iwasz/uniwersal/README.md

# uniwersal
Universal board and shields for it. Below is a photo of version 1.0
