iwasz/uniwersal/3battery/ref-1.png

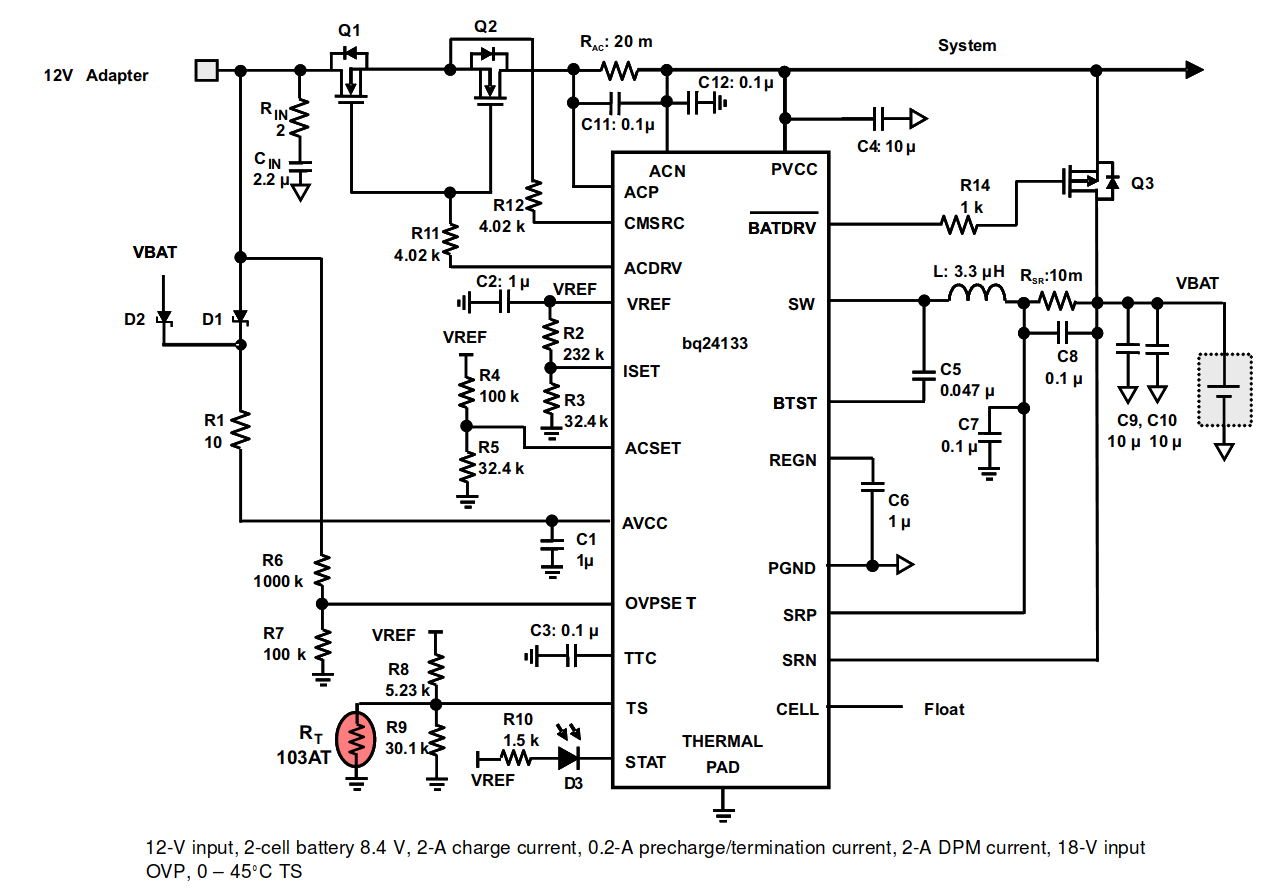
3battery/ref-1.png
