iwasz/uniwersal/3battery/ref-2.png

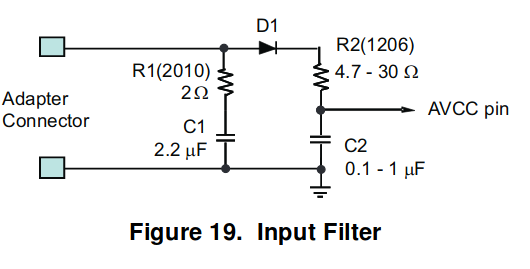
3battery/ref-2.png
