iwasz/uniwersal/3battery/ref-3.png

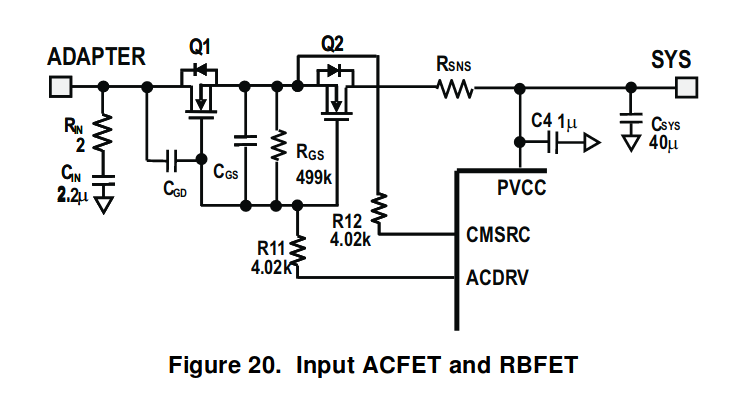
3battery/ref-3.png
