iwasz/uniwersal/3battery/3battery-Edge.Cuts.dxf

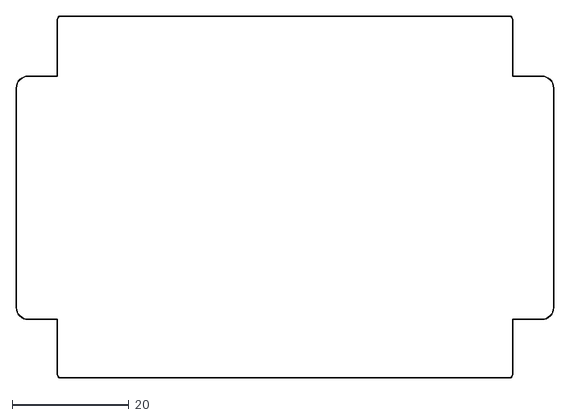
[picture p4: CAD file, 2018-02-04]
3battery/3battery-Edge.Cuts.dxf
92.0 x 61.9
