iwasz/uniwersal/3battery/3battery.kicad_pcb

## KiCad design 3battery/3battery.kicad_pcb (2018-04-09)

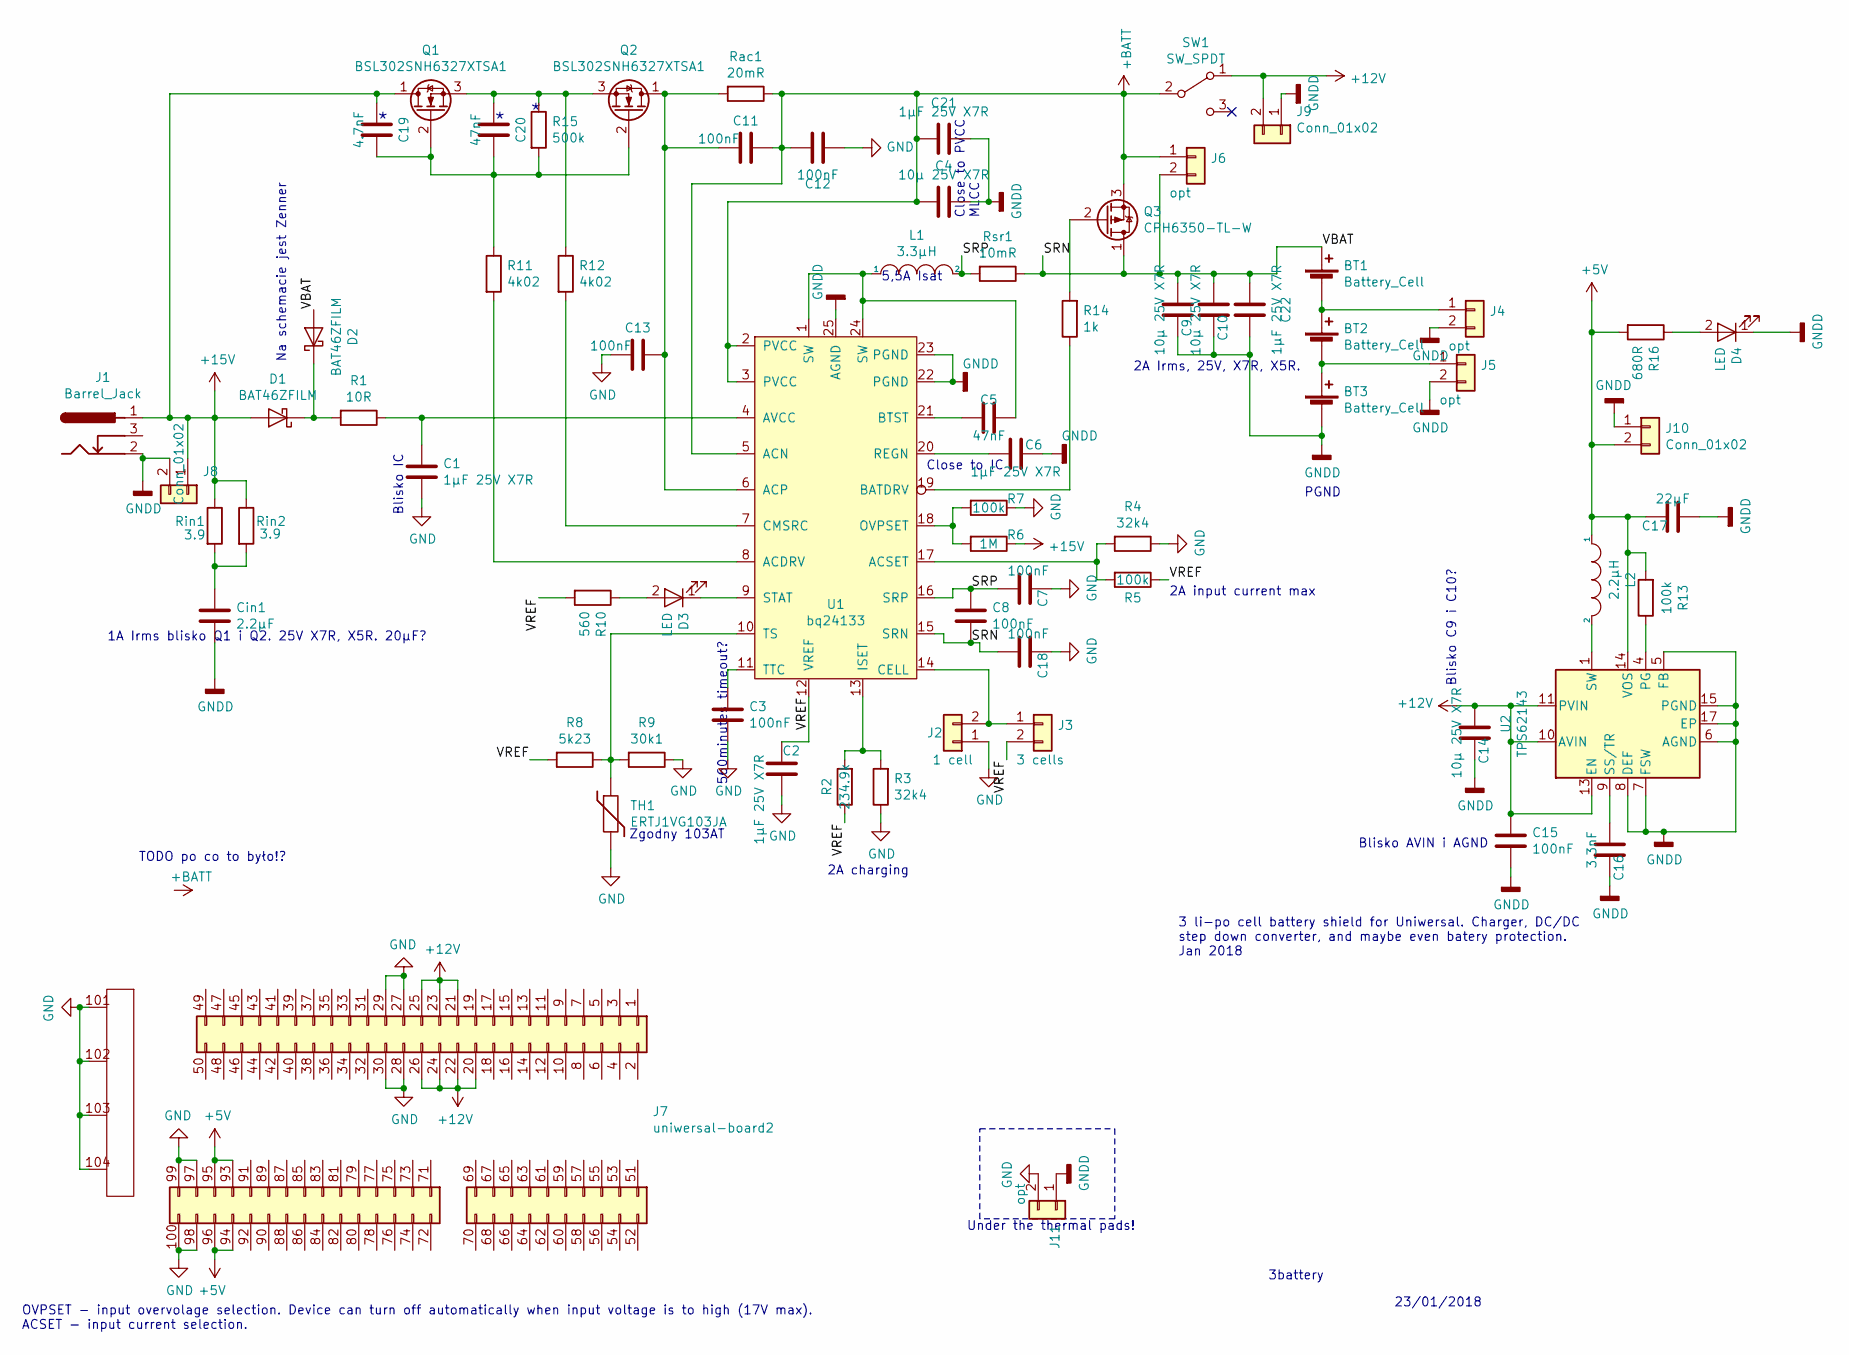
[picture p5: schematic 3battery.sch]

Parts:
BT1, BT2, BT3: Battery_Cell; BLM-BH18650-PC2
C1, C2, C6, C21, C22: 1µF 25V X7R; C_0805_2012Metric
C3, C7, C8, C11, C12, C13, C15, C18: 100nF; C_0603_1608Metric
C4, C9, C10, C14: 10µ 25V X7R; C_1206_3216Metric
C5, C20: 47nF; C_0603_1608Metric
C16: 3.3nF; C_0603_1608Metric
C17: 22µF; C_1206_3216Metric
C19: 4.7nF; C_0603_1608Metric
Cin1: 2.2µF; C_0805_2012Metric
D1, D2: BAT46ZFILM; D_SOD-123
D3, D4: LED; D_0805_2012Metric
J1: Barrel_Jack; BarrelJack_Horizontal
J2: 1 cell; SolderJumper-2_P1.3mm_Open_RoundedPad1.0x1.5mm
J3: 3 cells; SolderJumper-2_P1.3mm_Bridged_RoundedPad1.0x1.5mm
J4, J5, J6: opt; SolderJumper-2_P1.3mm_Open_RoundedPad1.0x1.5mm
J7: uniwersal-board2; uniwersal-board
J8, J9, J10: Conn_01x02; PinHeader_1x02_P2.54mm_Vertical
J11: opt; R_0402_1005Metric
L1: 3.3µH; L_7.3x7.3_H3.5
L2: 2.2µH; L_6.3x6.3_H3
Q1, Q2: BSL302SNH6327XTSA1; TSOP-6_1.65x3.05mm_P0.95mm-BSLMOSFET
Q3: CPH6350-TL-W; TSOT-23-6-POWER_MOSFET
R1: 10R; R_1206_3216Metric
R2: 234.9k; R_0603_1608Metric
R3, R4: 32k4; R_0603_1608Metric
R5, R7, R13: 100k; R_0603_1608Metric
R6: 1M; R_0603_1608Metric
R8: 5k23; R_0603_1608Metric
R9: 30k1; R_0603_1608Metric
R10: 560; R_0603_1608Metric
R11, R12: 4k02; R_0603_1608Metric
R14: 1k; R_0603_1608Metric
R15: 500k; R_0603_1608Metric
R16: 680R; R_0603_1608Metric
Rac1: 20mR; R_1206_3216Metric
Rin1, Rin2: 3.9; R_2010_5025Metric
Rsr1: 10mR; R_1206_3216Metric
SW1: SW_SPDT; SW_CuK_OS102011MA1QN1_SPDT_Angled
TH1: ERTJ1VG103JA; R_0603_1608Metric
U1: bq24133; R-PVQFN-N24
U2: TPS62143; QFN-16-1EP_3x3mm_P0.5mm_EP2.7x2.7mm_ThermalVias

Connections:
+5V: C17.1, J7.93 (Pin_23), J7.94 (Pin_24), J7.95 (Pin_25), J7.96 (Pin_26), J10.2, L2.1, R13.2, R16.2, U2.14 (VOS)
+12V: C14.2, C15.1, J7.20, J7.21, J7.22, J7.23, J7.24, J7.25, J7.26, J9.2, SW1.1 (A), U2.10 (AVIN), U2.11 (PVIN), U2.12 (PVIN), U2.13 (EN)
+15V: C19.1, D1.2 (A), J1.1, J8.1, Q1.1 (D), R6.1, Rin1.1, Rin2.1
+BATT: C4.2, C11.2, C12.1, C21.2, J6.1, Q3.3 (S), Rac1.1, SW1.2 (B), U1.2 (PVCC), U1.3 (PVCC), U1.5 (ACN)
/SRN: BT1.1 (+), C8.2, C9.2, C10.2, C18.2, C22.2, D2.2 (A), J6.2, Q3.1 (D), Rsr1.1, U1.15 (SRN)
/SRP: C7.2, C8.1, L1.2, Rsr1.2, U1.16 (SRP)
/VREF: C2.1, J3.2, R2.1, R5.1, R8.2, R10.2, U1.12 (VREF)
GND: C1.2, C2.2, C3.2, C7.1, C12.2, C13.1, C18.1, J2.1, J7.27, J7.28, J7.29, J7.30, J7.97 (Pin_27), J7.98 (Pin_28), J7.99 (Pin_29), J7.100 (Pin_30), J7.101, J7.102, J7.103, J7.104, J11.2, R3.1, R4.1, R7.1, R9.1, TH1.2
GNDD: BT3.2 (-), C4.1, C6.1, C9.1, C10.1, C14.1, C15.2, C16.1, C17.2, C21.1, C22.1, Cin1.2, D4.1 (K), J1.2, J4.2, J5.2, J8.2, J9.1, J10.1, J11.1, U1.22 (PGND), U1.23 (PGND), U1.25 (AGND), U2.5 (FB), U2.6 (AGND), U2.7 (FSW), U2.8 (DEF), U2.15 (PGND), U2.16 (PGND), U2.17 (EP)
unnamed: BT1.2 (-), BT2.1 (+), J4.1
unnamed: BT2.2 (-), BT3.1 (+), J5.1
unnamed: C1.1, R1.1, U1.4 (AVCC)
unnamed: C3.1, U1.11 (TTC)
unnamed: C5.1, L1.1, U1.1 (SW), U1.24 (SW)
unnamed: C5.2, U1.21 (BTST)
unnamed: C6.2, U1.20 (REGN)
unnamed: C11.1, C13.2, Q2.1 (D), Rac1.2, U1.6 (ACP)
unnamed: C16.2, U2.9 (SS/TR)
unnamed: C19.2, C20.2, Q1.2 (G), Q2.2 (G), R11.1, R15.2
unnamed: C20.1, Q1.3 (S), Q2.3 (S), R12.1, R15.1
unnamed: Cin1.1, Rin1.2, Rin2.2
unnamed: D1.1 (K), D2.1 (K), R1.2
unnamed: D3.1 (K), U1.9 (STAT)
unnamed: D3.2 (A), R10.1
unnamed: D4.2 (A), R16.1
unnamed: J2.2, J3.1, U1.14 (CELL)
unnamed: L2.2, U2.1 (SW), U2.2 (SW), U2.3 (SW)
unnamed: Q3.2 (G), R14.2
unnamed: R2.2, R3.2, U1.13 (ISET)
unnamed: R4.2, R5.2, U1.17 (ACSET)
unnamed: R6.2, R7.2, U1.18 (OVPSET)
unnamed: R8.1, R9.2, TH1.1, U1.10 (TS)
unnamed: R11.2, U1.8 (ACDRV)
unnamed: R12.2, U1.7 (CMSRC)
unnamed: R13.1, U2.4 (PG)
unnamed: R14.1, U1.19 (BATDRV)

Notes on the sheet:
Na schemacie jest Zenner
Blisko IC
3battery
23/01/2018
3 li-po cell battery shield for Uniwersal. Charger, DC/DC step down converter, and maybe even batery protection. Jan 2018
Blisko C9 i C10?
Blisko AVIN i AGND
OVPSET - input overvolage selection. Device can turn off automatically when input voltage is to high (17V max). ACSET - input current selection.
PGND
Close to PVCC MLCC
Close to IC
2A charging
2A input current max
560minutes timeout?
Zgodny 103AT
5,5A Isat
1A Irms blisko Q1 i Q2. 25V X7R, X5R. 20µF?
2A Irms, 25V, X7R, X5R.
Under the thermal pads!
TODO po co to było!?

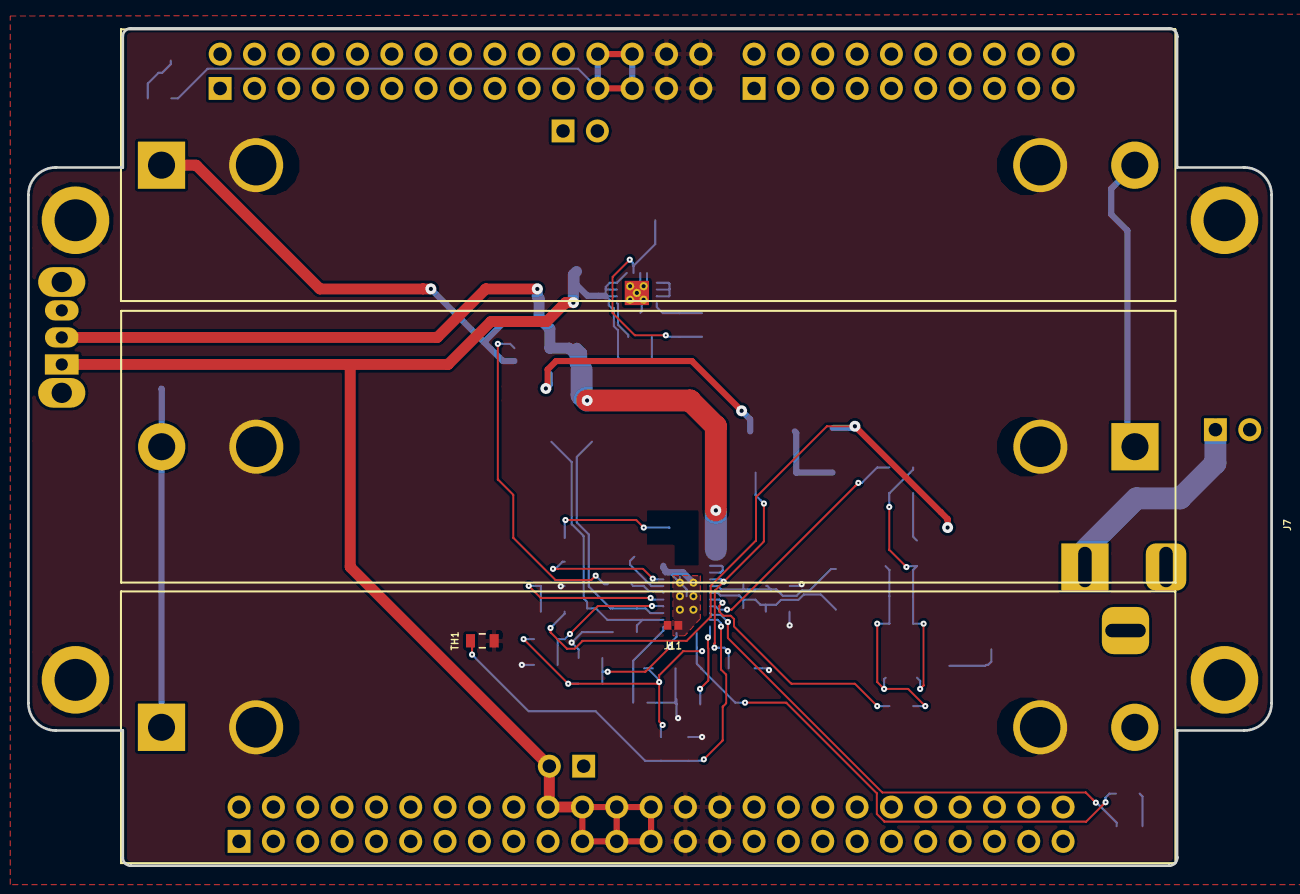
[picture p6: board 3battery.kicad_pcb from above]

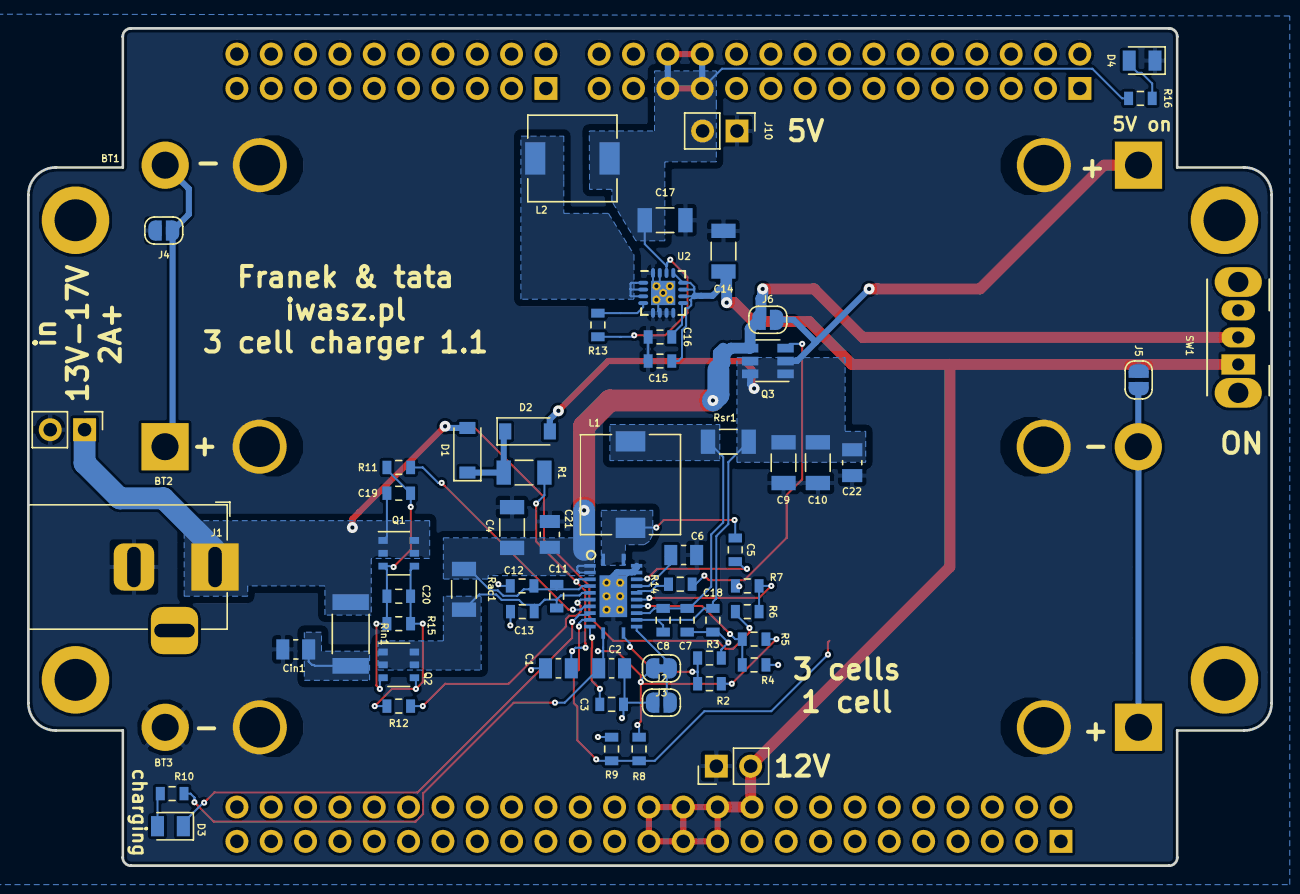
[picture p7: board 3battery.kicad_pcb from below]

Board: 2 copper layers, 92.0 x 61.9 mm, 69 parts (63 on the bottom side), 36 nets.
