iwasz/uniwersal/mainBoard/mainBoard.kicad_pcb

## KiCad design mainBoard/mainBoard.kicad_pcb (2018-04-09)

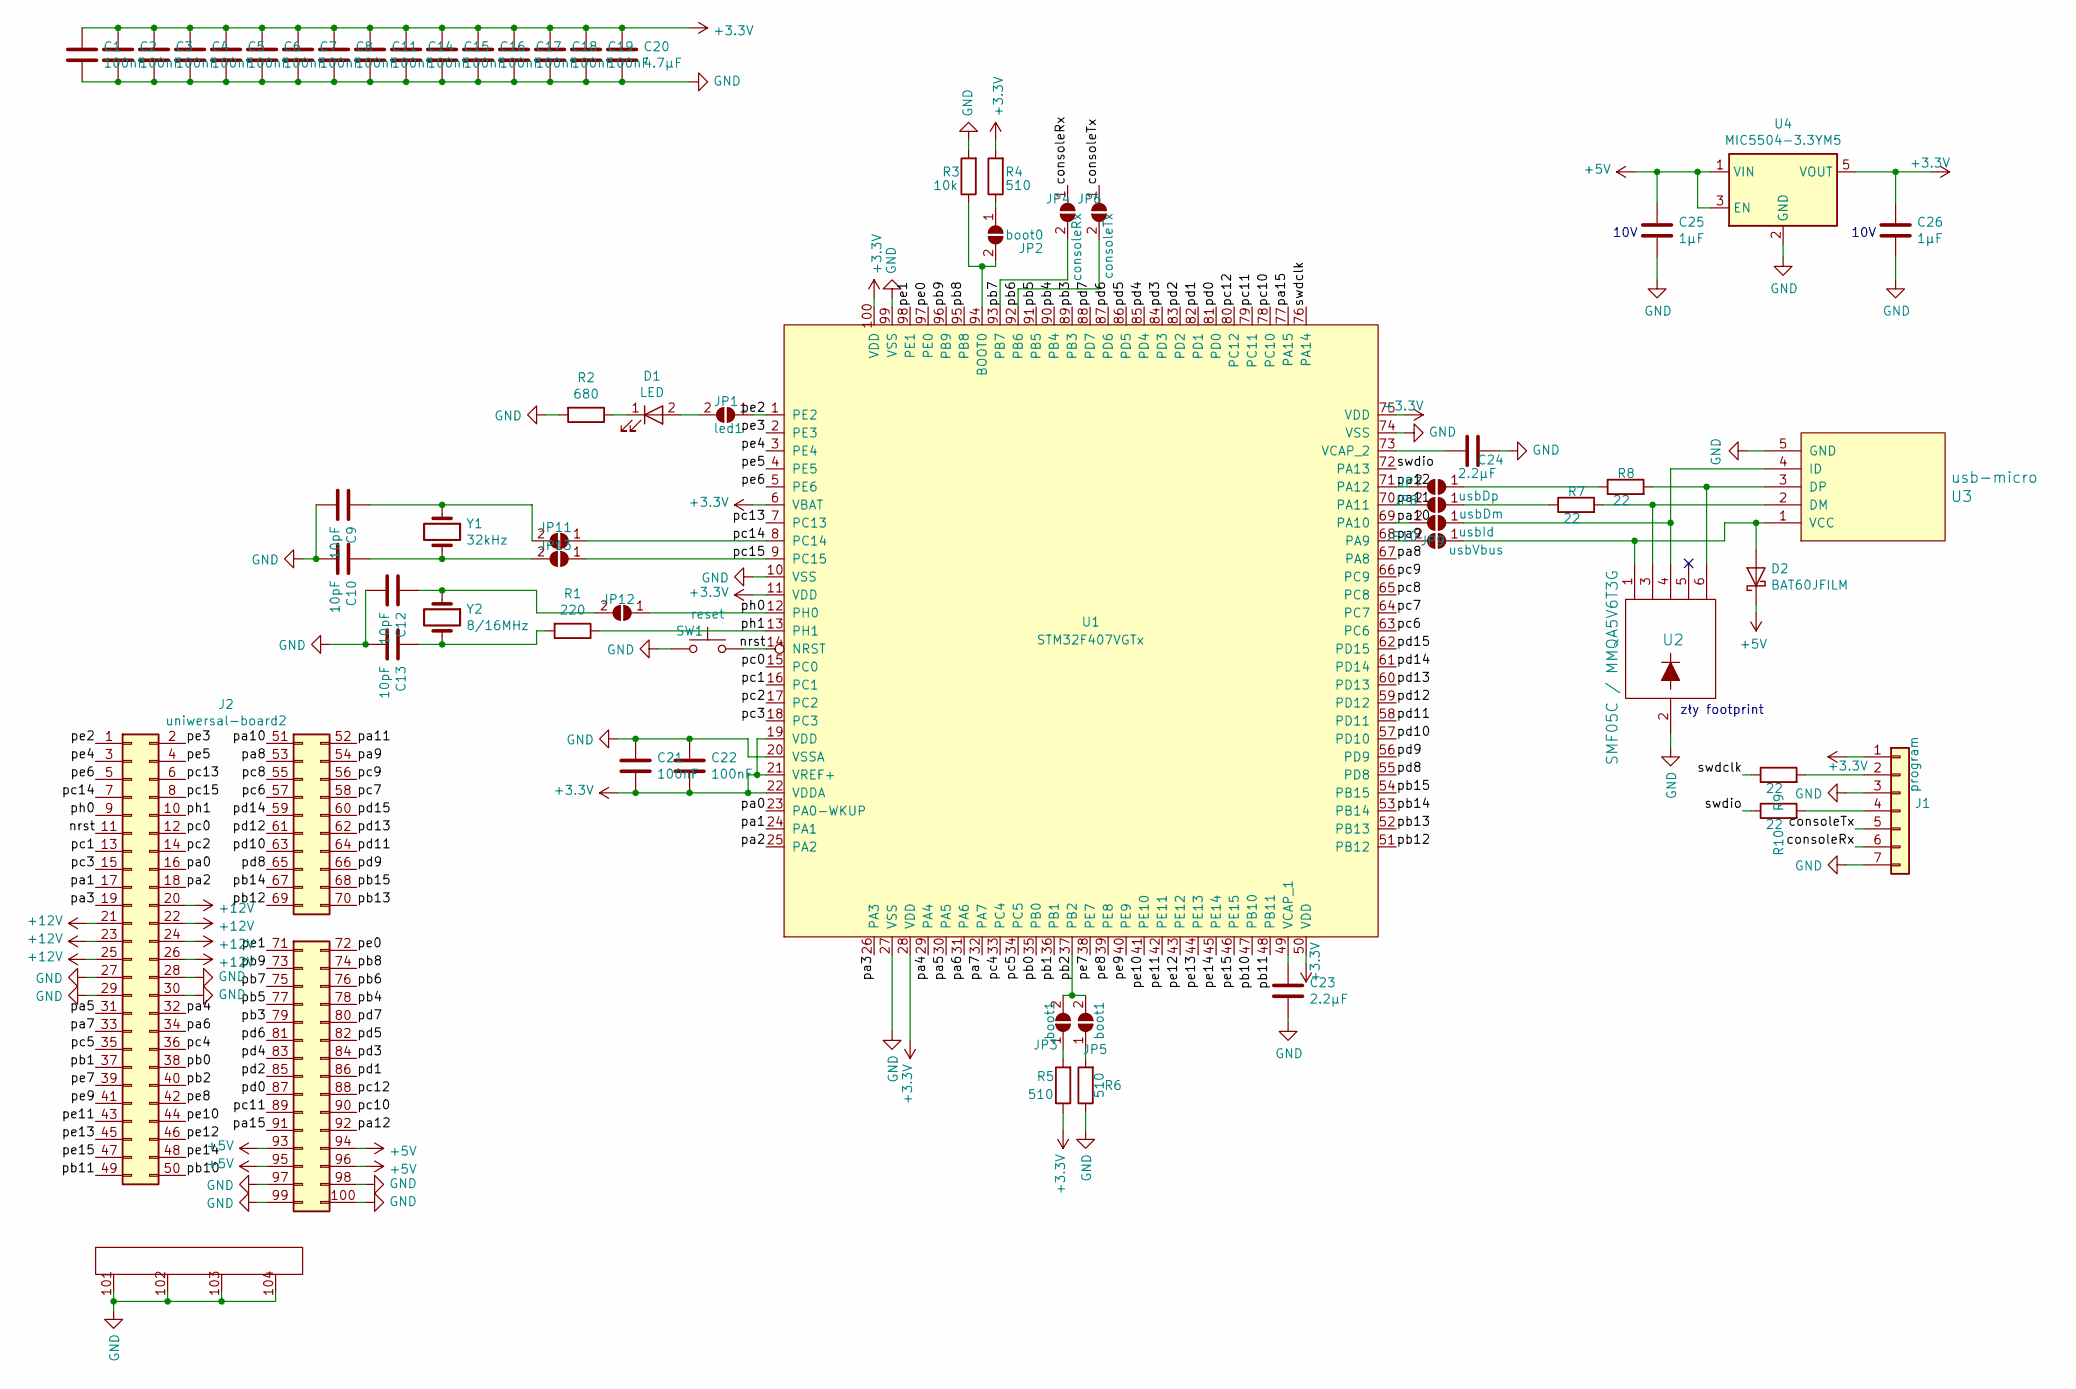
[picture p8: schematic mainBoard.sch]

Parts:
C1, C2, C3, C4, C5, C6, C7, C8, C11, C14, C15, C16, C17, C18, C19, C21, C22: 100nF; C_0603_1608Metric
C9, C10, C12, C13: 10pF; C_0603_1608Metric
C20: 4.7µF; C_1206_3216Metric
C23, C24: 2.2µF; C_1206_3216Metric
C25, C26: 1µF; C_0805_2012Metric
D1: LED; LED_0805_2012Metric
D2: BAT60JFILM; D_SOD-323
J1: program; PinHeader_1x07_P2.00mm_Vertical
J2: uniwersal-board2; uniwersal-board
JP1: led1; SolderJumper-2_P1.3mm_Open_RoundedPad1.0x1.5mm
JP2: boot0; SolderJumper-2_P1.3mm_Open_RoundedPad1.0x1.5mm
JP3, JP5: boot1; SolderJumper-2_P1.3mm_Open_RoundedPad1.0x1.5mm
JP4: consoleRx; SolderJumper-2_P1.3mm_Bridged_RoundedPad1.0x1.5mm
JP6: consoleTx; SolderJumper-2_P1.3mm_Bridged_RoundedPad1.0x1.5mm
JP7: usbDp; SolderJumper-2_P1.3mm_Bridged_RoundedPad1.0x1.5mm
JP8: usbDm; SolderJumper-2_P1.3mm_Bridged_RoundedPad1.0x1.5mm
JP9: usbId; SolderJumper-2_P1.3mm_Open_RoundedPad1.0x1.5mm
JP10: usbVbus; SolderJumper-2_P1.3mm_Open_RoundedPad1.0x1.5mm
JP11, JP13: x; SolderJumper-2_P1.3mm_Open_RoundedPad1.0x1.5mm
JP12: x32; SolderJumper-2_P1.3mm_Bridged_RoundedPad1.0x1.5mm
R1: 220; R_0603_1608Metric
R2: 680; R_0603_1608Metric
R3: 10k; R_0603_1608Metric
R4, R5, R6: 510; R_0603_1608Metric
R7, R8, R9, R10: 22; R_0603_1608Metric
SW1: reset; SW_Tactile_SPST_Angled_PTS645Vx83-2LFS
U1: STM32F407VGTx; LQFP-100_14x14mm_P0.5mm
U2: SMF05C / MMQA5V6T3G; SOT-363_SC-70-6
U3: usb-micro; conn_usb_B_micro_smd-2-nohole
U4: MIC5504-3.3YM5; SOT-23-5
Y1: 32kHz; Crystal_C38-LF_D3.0mm_L8.0mm_Horizontal
Y2: 8/16MHz; Crystal_HC49-4H_Vertical

Connections:
+3V3: C1.1, C2.1, C3.1, C4.1, C5.1, C6.1, C7.1, C8.1, C11.1, C14.1, C15.1, C16.1, C17.1, C18.1, C19.1, C20.1, C21.1, C22.2, C26.1, J1.1, R4.2, R5.1, U1.6 (VBAT), U1.11 (VDD), U1.19 (VDD), U1.21 (VREF+), U1.22 (VDDA), U1.28 (VDD), U1.50 (VDD), U1.75 (VDD), U1.100 (VDD), U4.5 (VOUT)
+5V: C25.1, D2.1 (K), J2.93 (Pin_23), J2.94 (Pin_24), J2.95 (Pin_25), J2.96 (Pin_26), U4.1 (VIN), U4.3 (EN)
+12V: J2.20, J2.21, J2.22, J2.23, J2.24, J2.25, J2.26
/consoleRx: J1.6, JP4.1 (A)
/consoleTx: J1.5, JP6.1 (A)
/nrst: J2.11, SW1.2, U1.14 (NRST)
/pa0: J2.16, U1.23 (PA0-WKUP)
/pa1: J2.17, U1.24 (PA1)
/pa2: J2.18, U1.25 (PA2)
/pa3: J2.19, U1.26 (PA3)
/pa4: J2.32, U1.29 (PA4)
/pa5: J2.31, U1.30 (PA5)
/pa6: J2.34, U1.31 (PA6)
/pa7: J2.33, U1.32 (PA7)
/pa8: J2.53 (Pin_3), U1.67 (PA8)
/pa9: J2.54, JP10.2 (B), U1.68 (PA9)
/pa10: J2.51 (Pin_1), JP9.2 (B), U1.69 (PA10)
/pa11: J2.52 (Pin_2), JP8.2 (B), U1.70 (PA11)
/pa12: J2.92 (Pin_22), JP7.2 (B), U1.71 (PA12)
/pa15: J2.91 (Pin_21), U1.77 (PA15)
/pb0: J2.38, U1.35 (PB0)
/pb1: J2.37, U1.36 (PB1)
/pb2: J2.40, JP3.2 (B), JP5.2 (B), U1.37 (PB2)
/pb3: J2.79 (Pin_9), U1.89 (PB3)
/pb4: J2.78 (Pin_8), U1.90 (PB4)
/pb5: J2.77 (Pin_7), U1.91 (PB5)
/pb6: J2.76 (Pin_6), JP6.2 (B), U1.92 (PB6)
/pb7: J2.75 (Pin_5), JP4.2 (B), U1.93 (PB7)
/pb8: J2.74 (Pin_4), U1.95 (PB8)
/pb9: J2.73 (Pin_3), U1.96 (PB9)
/pb10: J2.50, U1.47 (PB10)
/pb11: J2.49, U1.48 (PB11)
/pb12: J2.69, U1.51 (PB12)
/pb13: J2.70 (Pin_20), U1.52 (PB13)
/pb14: J2.67 (Pin_17), U1.53 (PB14)
/pb15: J2.68 (Pin_18), U1.54 (PB15)
/pc0: J2.12, U1.15 (PC0)
/pc1: J2.13, U1.16 (PC1)
/pc2: J2.14, U1.17 (PC2)
/pc3: J2.15, U1.18 (PC3)
/pc4: J2.36, U1.33 (PC4)
/pc5: J2.35, U1.34 (PC5)
/pc6: J2.57 (Pin_7), U1.63 (PC6)
/pc7: J2.58 (Pin_8), U1.64 (PC7)
/pc8: J2.55 (Pin_5), U1.65 (PC8)
/pc9: J2.56 (Pin_6), U1.66 (PC9)
/pc10: J2.90 (Pin_20), U1.78 (PC10)
/pc11: J2.89 (Pin_19), U1.79 (PC11)
/pc12: J2.88 (Pin_18), U1.80 (PC12)
/pc13: J2.6, U1.7 (PC13)
/pc14: J2.7, JP11.1 (A), U1.8 (PC14)
/pc15: J2.8, JP13.1 (A), U1.9 (PC15)
/pd0: J2.87 (Pin_17), U1.81 (PD0)
/pd1: J2.86 (Pin_16), U1.82 (PD1)
/pd2: J2.85 (Pin_15), U1.83 (PD2)
/pd3: J2.84 (Pin_14), U1.84 (PD3)
/pd4: J2.83 (Pin_13), U1.85 (PD4)
/pd5: J2.82 (Pin_12), U1.86 (PD5)
/pd6: J2.81, U1.87 (PD6)
/pd7: J2.80 (Pin_10), U1.88 (PD7)
/pd8: J2.65 (Pin_15), U1.55 (PD8)
/pd9: J2.66 (Pin_16), U1.56 (PD9)
/pd10: J2.63 (Pin_13), U1.57 (PD10)
/pd11: J2.64 (Pin_14), U1.58 (PD11)
/pd12: J2.61 (Pin_11), U1.59 (PD12)
/pd13: J2.62, U1.60 (PD13)
/pd14: J2.59 (Pin_9), U1.61 (PD14)
/pd15: J2.60 (Pin_10), U1.62 (PD15)
/pe0: J2.72 (Pin_2), U1.97 (PE0)
/pe1: J2.71 (Pin_1), U1.98 (PE1)
/pe2: J2.1, JP1.1 (A), U1.1 (PE2)
/pe3: J2.2, U1.2 (PE3)
/pe4: J2.3, U1.3 (PE4)
/pe5: J2.4, U1.4 (PE5)
/pe6: J2.5, U1.5 (PE6)
/pe7: J2.39, U1.38 (PE7)
/pe8: J2.42, U1.39 (PE8)
/pe9: J2.41, U1.40 (PE9)
/pe10: J2.44, U1.41 (PE10)
/pe11: J2.43, U1.42 (PE11)
/pe12: J2.46, U1.43 (PE12)
/pe13: J2.45, U1.44 (PE13)
/pe14: J2.48, U1.45 (PE14)
/pe15: J2.47, U1.46 (PE15)
/ph0: J2.9, JP12.1 (A), U1.12 (PH0)
/ph1: J2.10, R1.1, U1.13 (PH1)
/swdclk: R9.1, U1.76 (PA14)
/swdio: R10.1, U1.72 (PA13)
GND: C1.2, C2.2, C3.2, C4.2, C5.2, C6.2, C7.2, C8.2, C9.1, C10.1, C11.2, C12.1, C13.1, C14.2, C15.2, C16.2, C17.2, C18.2, C19.2, C20.2, C21.2, C22.1, C23.2, C24.1, C25.2, C26.2, J1.3, J1.7, J2.27, J2.28, J2.29, J2.30, J2.97 (Pin_27), J2.98 (Pin_28), J2.99 (Pin_29), J2.100 (Pin_30), J2.101, J2.102, J2.103, J2.104, R2.2, R3.2, R6.1, SW1.1, U1.10 (VSS), U1.20 (VSSA), U1.27 (VSS), U1.74 (VSS), U1.99 (VSS), U2.2, U3.5 (GND), U4.2 (GND)
unnamed: C9.2, JP11.2 (B), Y1.1
unnamed: C10.2, JP13.2 (B), Y1.2
unnamed: C12.2, JP12.2 (B), Y2.1
unnamed: C13.2, R1.2, Y2.2
unnamed: C23.1, U1.49 (VCAP_1)
unnamed: C24.2, U1.73 (VCAP_2)
unnamed: D1.1 (K), R2.1
unnamed: D1.2 (A), JP1.2 (B)
unnamed: D2.2 (A), JP10.1 (A), U2.1, U3.1 (VCC)
unnamed: J1.2, R9.2
unnamed: J1.4, R10.2
unnamed: JP2.1 (A), R4.1
unnamed: JP2.2 (B), R3.1, U1.94 (BOOT0)
unnamed: JP3.1 (A), R5.2
unnamed: JP5.1 (A), R6.2
unnamed: JP7.1 (A), R8.1
unnamed: JP8.1 (A), R7.1
unnamed: JP9.1 (A), U2.4, U3.4 (ID)
unnamed: R7.2, U2.3, U3.2 (DM)
unnamed: R8.2, U2.6, U3.3 (DP)

Notes on the sheet:
10V
zły footprint

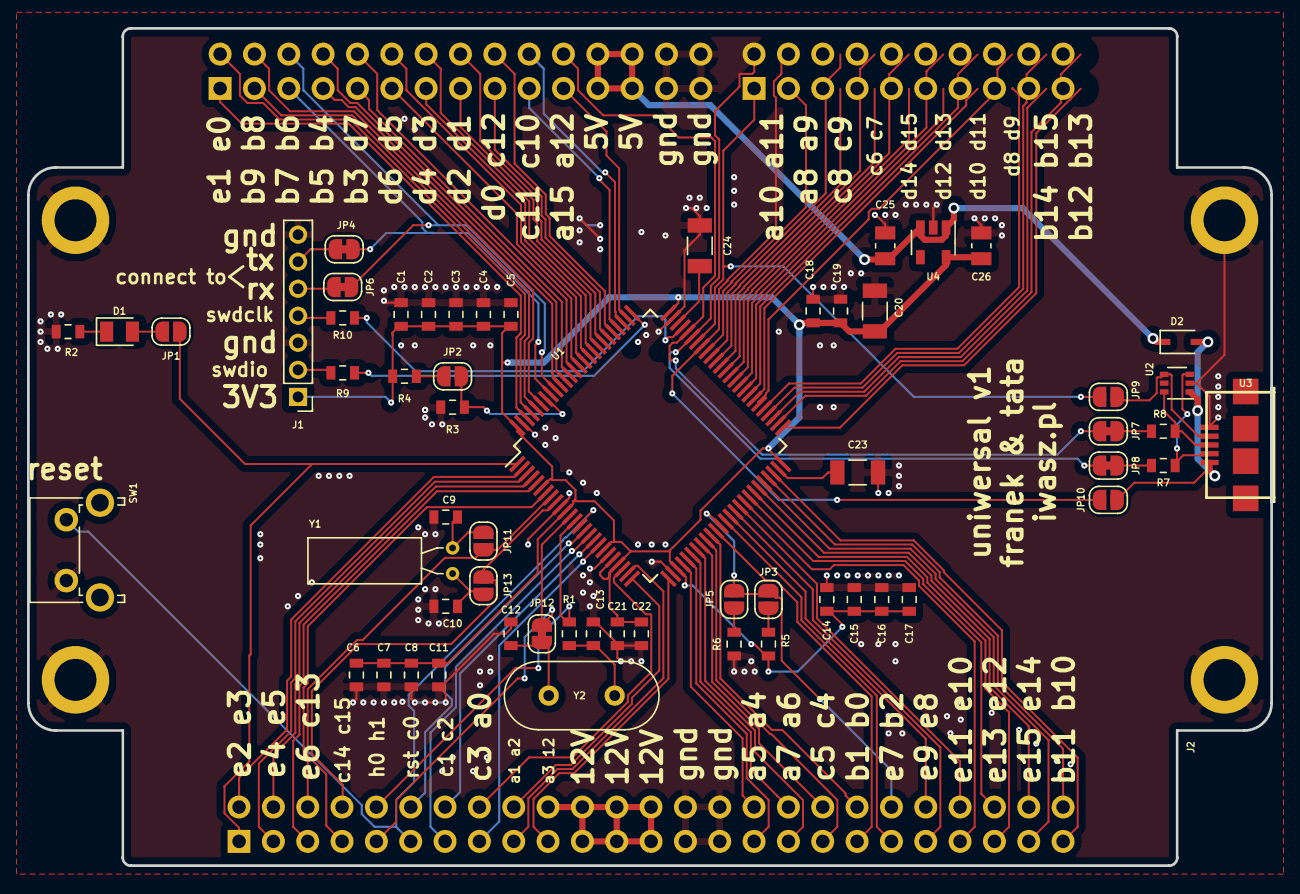
[picture p9: board mainBoard.kicad_pcb from above]

Board: 2 copper layers, 92.0 x 61.9 mm, 60 parts (0 on the bottom side), 109 nets.
