iwasz/uniwersal/mainBoard/mainBoard.ioc

Mcu.UserName=STM32F407VGTx
PA10.Signal=USB_OTG_FS_ID
PA11.Signal=USB_OTG_FS_DM
PA12.Signal=USB_OTG_FS_DP
PA9.Signal=GPIO_Input
PB6.Signal=USART1_TX
PB7.Signal=USART1_RX
PE2.Signal=GPIO_Output
