iwasz/uniwersal/(commit log)

2018-02-04 Main board and proto-board added
    [3battery-Edge.Cuts.dxf, 3battery.kicad_pcb, 3battery.sch, mainBoard.sch, protoShield.kicad_pcb, protoShield.sch]
2018-02-05 4 layers, but I plan to make it only 2.
    [3battery.kicad_pcb]
2018-02-07 Gerbers directory added, and domcumentation improved
    [3battery.kicad_pcb, 3battery.sch, mainBoard.sch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]
2018-04-09 Bug-fixes. 3 battery soldered and working.
    [3battery.kicad_pcb, 3battery.sch, mainBoard.kicad_pcb, mainBoard.sch]
